Fullerene1976/Integration-Nartis-D101-with-Home-Assistant/(notices)

Notices in the files:
soft/nartis_d101.ino:
This program is free software: you can redistribute it and/or modify
it under the terms of the GNU General Public License as published by
the Free Software Foundation, either version 3 of the License, or
any later version.
